Leke1Emmanuel/Location-tracking-device/3D CAD Model/Hardware_Tracker.SLDPRT

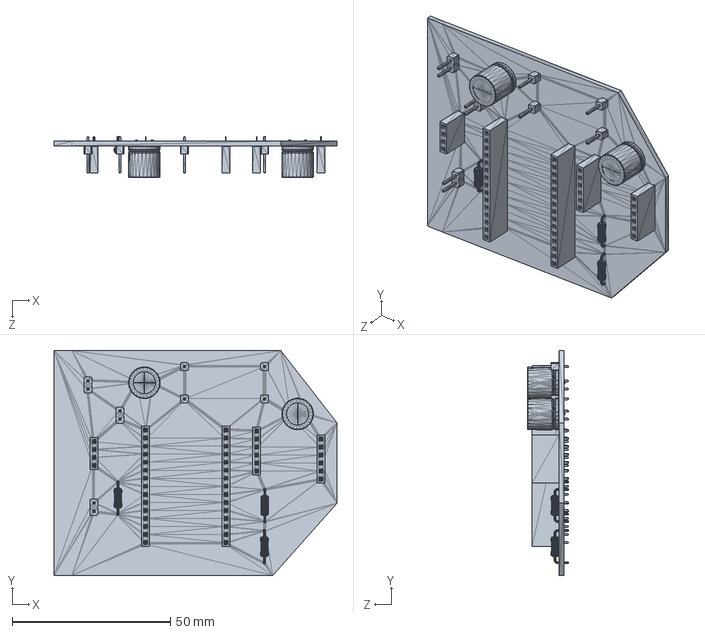
[picture p1: CAD file, 2026-10-23]
3D CAD Model/Hardware_Tracker.SLDPRT
89.5 x 71.2 x 13.1 mm
