Leke1Emmanuel/Location-tracking-device/3D CAD Model/neo6mGps.SLDPRT

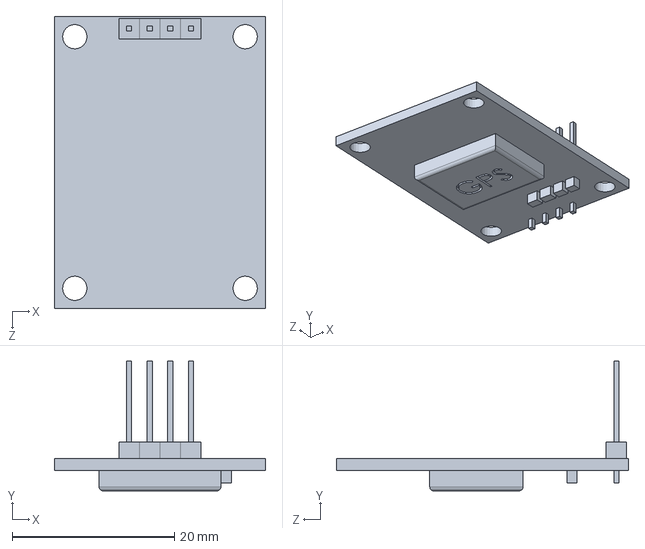
[picture p2: CAD file, 2026-10-23]
3D CAD Model/neo6mGps.SLDPRT
26.0 x 16.0 x 36.0 mm
