Leke1Emmanuel/Location-tracking-device/3D CAD Model/SIM800L v10.SLDPRT

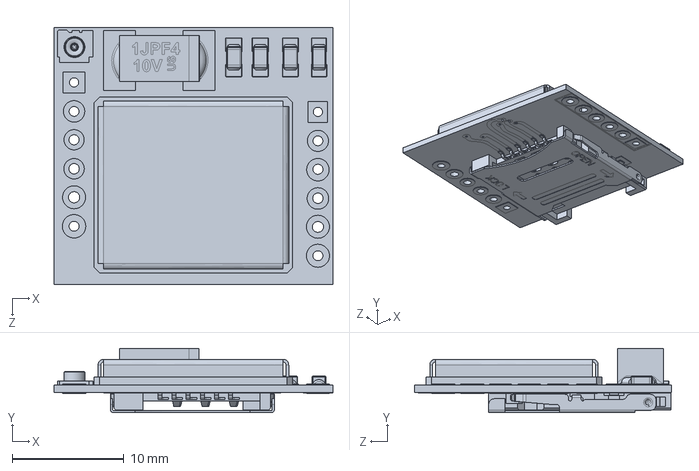
[picture p3: CAD file, 2026-10-23]
3D CAD Model/SIM800L v10.SLDPRT
25.0 x 5.77 x 23.0 mm
