Leke1Emmanuel/Location-tracking-device/3D CAD Model/Walter_Board.step

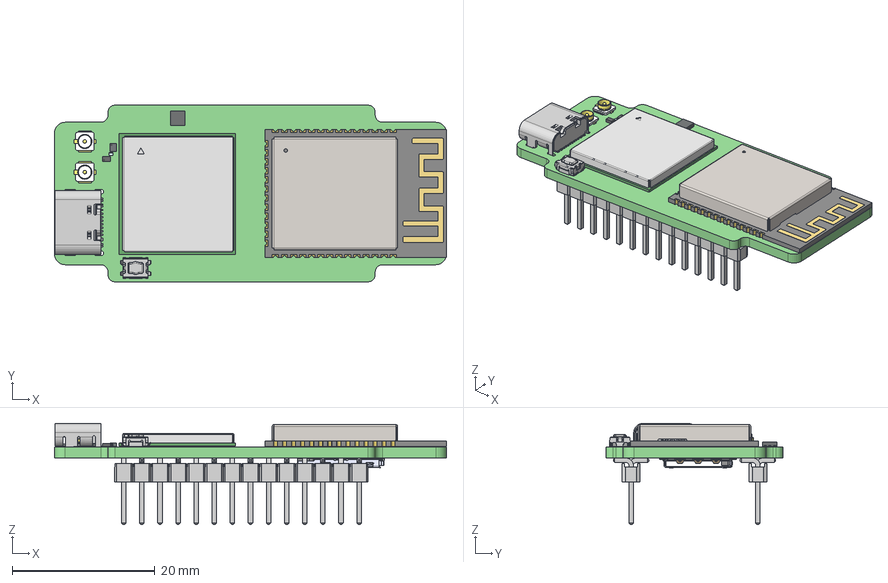
[picture p4: CAD file, 2026-10-23]
3D CAD Model/Walter_Board.step
55.0 x 24.8 x 14.2 mm
DPT S3 NB-IoT Module PCB
