Leke1Emmanuel/Location-tracking-device/3D CAD Model/safetrace.SLDASM

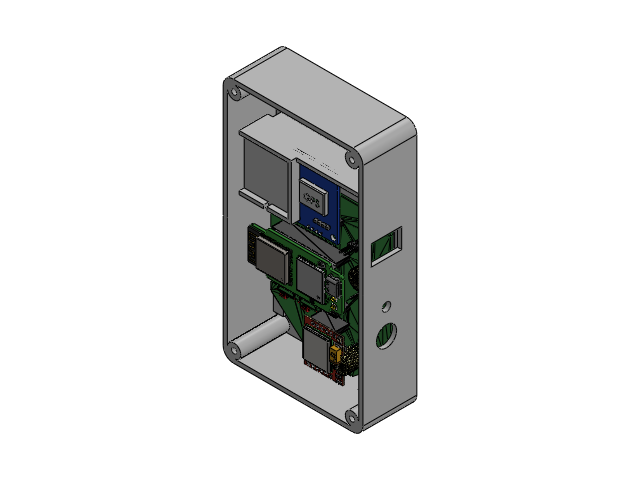
[picture p5: CAD file, 2026-10-23]
3D CAD Model/safetrace.SLDASM
SOLID.step
COMPOUND.step
COMPOUND_7.step x 2
COMPOUND_1.step
COMPOUND_2.step
COMPOUND_3.step
COMPOUND_4.step
COMPOUND_5.step
SOLID_1.step
COMPOUND_6.step
COMPOUND_8.step x 2
DPT S3 NB-IoT Module PCB.step
neo6mGps
SIM800L v10
Hardware_Tracker
safetrace
