Leke1Emmanuel/Location-tracking-device/(list of files, cad)

Other CAD files:
3D CAD Model/safetrace.SLDPRT
